lucasdinnouti/MC851/diagrama.png

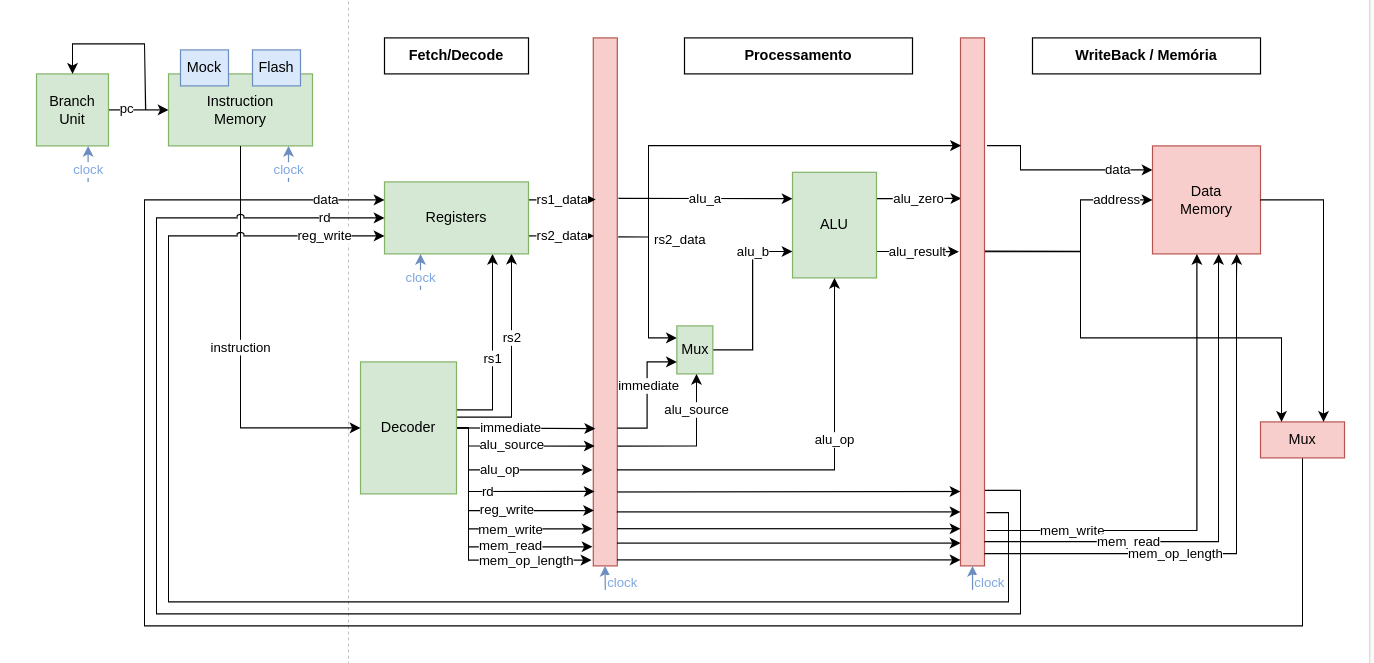
diagrama.png
