lucasdinnouti/MC851/src/memory/memory_controller.v

module memory_controller (
    input wire [31:0] l1i_address,
    input wire [31:0] l1d_address,
    input wire [31:0] l1d_input_data,
    input wire l1i_mem_read,
    input wire l1d_mem_write,
    input wire l1d_mem_read,
    input wire clock,
    input wire [3:0] input_peripherals,
    output wire [3:0] output_peripherals,
    output wire [31:0] output_data,
    output wire [1:0] data_source,
    output wire stall_l1i,
    output wire stall_l1d
);
  parameter ROM_SIZE = 64;
  parameter RAM_SIZE = 64;

  assign stall_l1d = 0;
  assign stall_l1i = (l1d_mem_read || l1d_mem_write) && l1i_mem_read;

  wire per_out;
  wire per_in;
  wire [31:0] ram_output;
  wire [31:0] rom_output;
  wire [31:0] per_output;

  wire peripheral_op;
  assign peripheral_op = (l1d_mem_write || l1d_mem_read) && l1d_address[9];

  assign output_data = peripheral_op ? per_output : (l1d_mem_read ? ram_output : (l1d_mem_write ? 32'h0 : rom_output));
  assign data_source = peripheral_op ? `DATA_SOURCE_PER : ((l1d_mem_read || l1d_mem_write) ? `DATA_SOURCE_RAM : `DATA_SOURCE_ROM);

  rom #(ROM_SIZE) rom (
      .address(l1i_address),
      .clock(clock),
      .output_data(rom_output)
  );

  wire [31:0] ram_address;
  assign ram_address = l1d_address - (ROM_SIZE << 2);

  ram #(RAM_SIZE) ram (
      .address($signed(ram_address) < 0 ? 0 : ram_address),
      .input_data(l1d_input_data),
      .should_write((~peripheral_op && l1d_mem_write)),
      .clock(clock),
      .output_data(ram_output)
  );

  peripherals peripherals (
      .address(l1d_address),
      .input_data(l1d_input_data),
      .should_write((peripheral_op && l1d_mem_write)),
      .clock(clock),
      .input_peripherals(input_peripherals),
      .output_peripherals(output_peripherals),
      .output_data(per_output)
  );
endmodule
