lucasdinnouti/MC851/src/constants.v

`define ALU_ADD_OP 5'b00000
`define ALU_SUB_OP 5'b01000
`define ALU_SLL_OP 5'b00001
`define ALU_XOR_OP 5'b00100
`define ALU_OR_OP 5'b00110
`define ALU_AND_OP 5'b00111
`define ALU_SRL_OP 5'b00101
`define ALU_SRA_OP 5'b01101
`define ALU_SLT_OP 5'b00010
`define ALU_SLTU_OP 5'b00011
`define ALU_MUL_OP 5'b10000
`define ALU_MULH_OP 5'b10001
`define ALU_MULHSU_OP 5'b10010
`define ALU_MULHU_OP 5'b10011
`define ALU_DIV_OP 5'b10100
`define ALU_DIVU_OP 5'b10101
`define ALU_REM_OP 5'b10110
`define ALU_REMU_OP 5'b10111

`define LOAD_OP 7'b0000011
`define STORE_OP 7'b0100011
`define IMM_OP 7'b0010011
`define REG_OP 7'b0110011
`define BRANCH_OP 7'b1100011
`define ATOMIC_OP 7'b0101111
`define JAL_OP 7'b1101111
`define JALR_OP 7'b1100111
`define LUI_OP 7'b0110111

`define LW_COMPACT_OP 5'b01000
`define LWSP_COMPACT_OP 5'b01010
`define SW_COMPACT_OP 5'b11000
`define SWSP_COMPACT_OP 5'b11010
`define ADDI_COMPACT_OP 5'b00001
`define ADDI_4SPN_COMPACT_OP 5'b00000
`define ADDI_16SP_LUI_COMPACT_OP 5'b01101
`define LI_COMPACT_OP 5'b01001
`define J_COMPACT_OP 5'b10101
`define JALR_ADD_COMPACT_OP 5'b10010
`define JAL_COMPACT_OP 5'b00101
`define BEQZ_COMPACT_OP 5'b11001
`define BNEZ_COMPACT_OP 5'b11101
`define ALU_OPS_COMPACT_OP 5'b10001
`define SLLI_COMPACT_OP 5'b00010

`define MEM_WORD 3'b010
`define MEM_HALF 3'b001
`define MEM_BYTE 3'b000
`define MEM_HALF_U 3'b101
`define MEM_BYTE_U 3'b100

`define INSTRUCTION_MEMORY_SIZE 4'd8

`define BRANCH_EQ 4'b0000
`define BRANCH_NE 4'b0001
`define BRANCH_NONE 4'b0010
`define BRANCH_LT 4'b0100
`define BRANCH_GE 4'b0101
`define BRANCH_LTU 4'b0110
`define BRANCH_GEU 4'b0111
`define BRANCH_JAL 4'b1000
`define BRANCH_JALR 4'b1001

`define ATOMIC_SWAP_OP 5'b00001
`define ATOMIC_ADD_OP 5'b00000
`define ATOMIC_XOR_OP 5'b00100
`define ATOMIC_AND_OP 5'b01100
`define ATOMIC_OR_OP 5'b01000
`define ATOMIC_MIN_OP 5'b10000
`define ATOMIC_MAX_OP 5'b10100
`define ATOMIC_MINU_OP 5'b11000
`define ATOMIC_MAXU_OP 5'b11100
`define ATOMIC_NO_OP 5'b11111

`define DATA_SOURCE_NONE 2'b00
`define DATA_SOURCE_ROM 2'b01
`define DATA_SOURCE_RAM 2'b10
`define DATA_SOURCE_PER 2'b11

`define SIGN_POSITIVE 1'b0
`define SIGN_NEGATIVE 1'b1
