lucasdinnouti/MC851/src/ex_mem_pipeline_registers.v

module ex_mem_pipeline_registers (
    input wire clock,
    input wire [31:0] ex_result,
    input wire [31:0] ex_rs2_data_forwarded,
    input wire [4:0] ex_rd,
    input wire ex_reg_write,
    input wire ex_mem_write,
    input wire ex_mem_read,
    input wire [2:0] ex_mem_op_length,
    input wire [4:0] ex_atomic_op,
    input wire reset,
    output wire [31:0] mem_result,
    output wire [31:0] mem_rs2_data_forwarded,
    output wire [4:0] mem_rd,
    output wire mem_reg_write,
    output wire mem_mem_write,
    output wire mem_mem_read,
    output wire [2:0] mem_mem_op_length,
    output wire [4:0] mem_atomic_op
);
  reg [31:0] result = 0;
  reg [31:0] rs2_data_forwarded = 0;
  reg [4:0] rd = 0;
  reg reg_write = 0;
  reg mem_write = 0;
  reg mem_read = 0;
  reg [2:0] mem_op_length = 0;
  reg [4:0] atomic_op = `ATOMIC_NO_OP;

  assign mem_result = result;
  assign mem_rs2_data_forwarded = rs2_data_forwarded;
  assign mem_rd = rd;
  assign mem_reg_write = reg_write;
  assign mem_mem_write = mem_write;
  assign mem_mem_read = mem_read;
  assign mem_mem_op_length = mem_op_length;
  assign mem_atomic_op = atomic_op;

  always @(posedge clock) begin
    if (reset) begin
      result <= 0;
      rs2_data_forwarded <= 0;
      rd <= 0;
      reg_write <= 0;
      mem_write <= 0;
      mem_read <= 0;
      mem_op_length <= 0;
      atomic_op <= `ATOMIC_NO_OP;
    end else begin
      result <= ex_result;
      rs2_data_forwarded <= ex_rs2_data_forwarded;
      rd <= ex_rd;
      reg_write <= ex_reg_write;
      mem_write <= ex_mem_write;
      mem_read <= ex_mem_read;
      mem_op_length <= ex_mem_op_length;
      atomic_op <= ex_atomic_op;
    end
  end
endmodule
