lucasdinnouti/MC851/src/registers.v

module registers (
    input wire [4:0] rs1,
    input wire [4:0] rs2,
    input wire [4:0] rd,
    input wire [31:0] data,
    input wire reg_write,
    input wire clock,
    output wire [31:0] rs1_data,
    output wire [31:0] rs2_data
);

  reg [31:0] registers[31:0];
  integer i;
  initial begin
    for (i = 0; i < 32; i = i + 1) begin
      registers[i] = 32'd0;
    end
  end

  assign rs1_data = registers[rs1];
  assign rs2_data = registers[rs2];

  always @(negedge clock) begin
    if (reg_write && rd != 0) begin
      registers[rd] <= data;
    end
  end
endmodule
