lucasdinnouti/MC851/(commit log)

2023-08-23 feat: adds block on button, increases intruction memory
2023-08-24 feat: fixes d-latch problems and implement pipeline registers
    [alu.v, cpu.v, id_ex_pipeline_registers.v, if_id_pipeline_registers.v, instruction_memory.v, registers.v]
2023-08-25 Refactoring mock to test folder and fix ALU tests
    [alu.v, alu_tb.v, mock_cpu.v]
2023-09-22 adding two photo resistors pins
2023-09-22 feat: adds reset signal to memory
    [l1.v, memory.v]
2023-09-22 Separate last stage into memory and write back
2023-09-22 Disable memory controller and peripherals, various fixes
    [alu.v, cpu.v, cpu_tb.v, ex_mem_pipeline_registers.v, memory.v, mock_cpu.v, registers.v]
2023-09-23 Fix branch hazard with noop instruction
    [branch.v, cpu.v]
2023-09-27 Fix forwarding and branch instructions
    [branch.v, cpu.v, cpu_tb.v, ex_mem_pipeline_registers.v, forwarding.v, id_ex_pipeline_registers.v, if_id_pipeline_registers.v, registers.v]
2023-09-29 feat: starts fixing FPGA issues
    [cpu.v, if_id_pipeline_registers.v, memory_controller.v, registers.v, rom.v]
2023-10-06 Fixes to run on simulator
    [cpu.v, if_id_pipeline_registers.v, l1.v, memory_controller.v, registers.v]
2023-10-24 Various fixes for execution with new memory controller
    [alu.v, atomic.v, branch.v, cpu.v, decoder.v, forwarding.v, id_ex_pipeline_registers.v, if_id_pipeline_registers.v]
2023-10-25 fix: change peripherals data to single bit registers
    [memory_controller.v, peripherals.v]
2023-10-26 Add more test cases and fixes to memory logic
    [alu.v, cpu.v, memory_controller.v, registers.v]
2023-10-27 Fixes to cache logic
    [constants.v, cpu.v, l1.v, memory_controller.v]
2023-11-09 Fixes to peripherals and cache
    [cpu.v, l1.v, memory_controller.v, peripherals.v]
2023-11-10 fixing ports and adding a new program
    [cpu.v, peripherals.v]
2023-11-24 Fix led address
2023-11-28 Fix divider and related tests
    [alu.v, alu_tb.v, divider.v]
2023-12-01 feature: separate calibrate and radar programs
